LYH-94/BalanceCar/README.md

# 平衡車 ( BalanceCar )

無回授步進馬達版本：[BalanceCar_StepMotor](https://github.com/LYH-94/BalanceCar/tree/main/BalanceCar_StepMotor)
