LYH-94/BalanceCar/BalanceCar_StepMotor/Core/Src/main.c

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
/* Includes ------------------------------------------------------------------*/
#include "main.h"

/* USER CODE BEGIN Includes */
#include <stdlib.h>
#include "mpu6050.h"
#include "A4988_Driver.h"

/* USER CODE END Includes */

/* USER CODE BEGIN PD */
#ifdef __GNUC__
  #define PUTCHAR_PROTOTYPE int __io_putchar(int ch)
#else#define PUTCHAR_PROTOTYPE int fputc(int ch, FILE *f)
#endif /* __GNUC__ */
/* USER CODE END PD */

I2C_HandleTypeDef hi2c1;

TIM_HandleTypeDef htim2;
TIM_HandleTypeDef htim3;

UART_HandleTypeDef huart2;

/* USER CODE BEGIN PV */
MPU6050_HandleTypeDef MPU6050;
uint8_t count1 = 0, count2 = 0;

double balance_point = 6.0;
double reference_input_angle = 0.0;
double reference_input_speed = 0.0;

double error_angle = 0.0;
double error_speed = 0.0;
double error_speed_LFP = 0.0, alpha = 0.2;  // LPF means low pass filter.
double control_law_angle = 0.0;
double control_law_speed = 0.0;
double control_law_speed_LFP = 0.0, beta = 0.5;

double PID_speed_time = 0.0;
double PID_speed_delta_time = 0.0;
double PID_speed_integral = 0.0;
double PID_speed_error_pre = 0.0;

double PID_angle_time = 0.0;
double PID_angle_delta_time = 0.0;
double PID_angle_integral = 0.0;

/* USER CODE END PV */

void SystemClock_Config(void);
static void MX_GPIO_Init(void);
static void MX_USART2_UART_Init(void);
static void MX_I2C1_Init(void);
static void MX_TIM2_Init(void);
static void MX_TIM3_Init(void);
/* USER CODE BEGIN PFP */
double PID_angle_controller(double error);
double PID_speed_controller(double error);

/* USER CODE END PFP */

/**
  * @brief  The application entry point.
  * @retval int
  */
int main(void)
{
  /* MCU Configuration--------------------------------------------------------*/

  /* Reset of all peripherals, Initializes the Flash interface and the Systick. */
  HAL_Init();

  /* Configure the system clock */
  SystemClock_Config();

  /* USER CODE BEGIN SysInit */
  SysTick_Config(SystemCoreClock / 1000);

  /* USER CODE END SysInit */

  /* Initialize all configured peripherals */
  MX_GPIO_Init();
  MX_USART2_UART_Init();
  MX_I2C1_Init();
  MX_TIM2_Init();
  MX_TIM3_Init();
  /* USER CODE BEGIN 2 */
  StepMotorDriver_Iint(&htim2);
  StepMotorDriver_Iint(&htim3);

  if (mpu6050_Init_Correction(&hi2c1, &MPU6050) == 1)
  {
    Error_Handler();
  }

  /* USER CODE END 2 */

  /* Infinite loop */
  /* USER CODE BEGIN WHILE */
  while (1)
  {
    /* USER CODE END WHILE */

    /* USER CODE BEGIN 3 */
	while(count1 == 1)
	{
		KalmanFilter_getAngle(&hi2c1, &MPU6050);

		error_speed = reference_input_speed + control_law_speed_LFP;
		error_speed_LFP = alpha * error_speed + (1-alpha) * error_speed_LFP;  // Low pass filter
		control_law_angle = PID_speed_controller(error_speed_LFP);

		error_angle = reference_input_angle - MPU6050.KalmanFilter_AngleX + balance_point;
		control_law_speed = PID_angle_controller(error_angle) + control_law_angle;

		control_law_speed_LFP = beta * control_law_speed + (1-beta) * control_law_speed_LFP;  // Low pass filter

		if(control_law_speed_LFP > 1081.73) control_law_speed_LFP = 1081.73;  // Maximum limit
		if(control_law_speed_LFP < -1081.73) control_law_speed_LFP = -1081.73;

		printf("KF_AngleX = %f \t, error_angle = %f \t, control_law_speed_LFP = %f\n" \
				, MPU6050.KalmanFilter_AngleX, error_angle, control_law_speed_LFP);

		if(abs((int)error_angle) > 45)
		{
			StepMotor_Stop(&htim2);
			StepMotor_Stop(&htim3);
		}
		else if(abs((int)control_law_speed_LFP) < 1.502)
		{
			StepMotor_Stop(&htim2);
			StepMotor_Stop(&htim3);
		}
		else
		{
			// control_law_speed_LFP (unit:deg/sec)(>0 = forward; <0 = back), (1=left motor; 0=right motor)
			StepMotor_Control(&htim2, control_law_speed_LFP, 1);
			StepMotor_Control(&htim3, control_law_speed_LFP, 0);
		}

		while(count1 == 1 && count2 > 2)
		{
			StepMotor_Stop(&htim2);
			StepMotor_Stop(&htim3);
		}
	}
  }
  /* USER CODE END 3 */
}

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
/* USER CODE BEGIN 4 */
double PID_angle_controller(double error)
{
	uint8_t index = 0;
	double P = 0.0, I = 0.0, D = 0.0;
	double Kp = 15.0, Ki = 5.0, Kd = 1.5;
	double u = 0.0;

	PID_angle_delta_time = (double)(HAL_GetTick() - PID_angle_time) / 1000;
	PID_angle_time = HAL_GetTick();

	P = Kp * error;

	if(abs((int)error) > 45)  // Integral separation method
	{
		index = 0;
	}
	else
	{
		index = 1;
		PID_angle_integral += error * PID_angle_delta_time/1000.0;
	}
	I = Ki * PID_angle_integral;
	if(I > 1000) I = 1000;  // Maximum limit I
	if(I < -1000) I = -1000;

	D = Kd * MPU6050.Gyro_Y_AngVel;

	u = P + index * I + D;

	return u;
}

double PID_speed_controller(double error)
{
	double P = 0.0, I = 0.0, D = 0.0;
	double Kp = 1.03, Ki = Kp/200.0, Kd = 0.0;
	double u = 0.0;

	PID_speed_delta_time = (double)(HAL_GetTick() - PID_speed_time) / 1000;
	PID_speed_time = HAL_GetTick();

	P = Kp * error;

	PID_speed_integral += error * PID_speed_delta_time/1000.0;
	I = Ki * PID_speed_integral;
	if(I > 1000) I = 1000;  // Maximum limit I
	if(I < -1000) I = -1000;

	D = Kd * (error - PID_speed_error_pre)/(PID_speed_delta_time/1000.0);
	PID_speed_error_pre = error;

	u = P + I + D;

	return u;
}

void HAL_GPIO_EXTI_Callback(uint16_t GPIO_Pin)
{
  /* Prevent unused argument(s) compilation warning */
  UNUSED(GPIO_Pin);
  /* NOTE: This function Should not be modified, when the callback is needed,
           the HAL_GPIO_EXTI_Callback could be implemented in the user file
   */

  if(GPIO_Pin == B1_Pin){
        count1 = 1;
	count2 += 1;
  }
}

PUTCHAR_PROTOTYPE
{
HAL_UART_Transmit(&huart2, (uint8_t *)&ch, 1, 0xFFFF);
return ch;
}

/* USER CODE END 4 */
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
