LYH-94/BalanceCar/BalanceCar_StepMotor/Core/Inc/main.h

#define B1_Pin GPIO_PIN_13
#define B1_GPIO_Port GPIOC
#define B1_EXTI_IRQn EXTI15_10_IRQn
#define USART_TX_Pin GPIO_PIN_2
#define USART_TX_GPIO_Port GPIOA
#define USART_RX_Pin GPIO_PIN_3
#define USART_RX_GPIO_Port GPIOA
#define LD2_Pin GPIO_PIN_5
#define LD2_GPIO_Port GPIOA
#define PB12_ENA_Pin GPIO_PIN_12
#define PB12_ENA_GPIO_Port GPIOB
#define PB13_MS1_Pin GPIO_PIN_13
#define PB13_MS1_GPIO_Port GPIOB
#define PB14_MS2_Pin GPIO_PIN_14
#define PB14_MS2_GPIO_Port GPIOB
#define PB15_MS3_Pin GPIO_PIN_15
#define PB15_MS3_GPIO_Port GPIOB
#define PA8_DIR_L_Pin GPIO_PIN_8
#define PA8_DIR_L_GPIO_Port GPIOA
#define PA9_DIR_R_Pin GPIO_PIN_9
#define PA9_DIR_R_GPIO_Port GPIOA
#define TMS_Pin GPIO_PIN_13
#define TMS_GPIO_Port GPIOA
#define TCK_Pin GPIO_PIN_14
#define TCK_GPIO_Port GPIOA
#define SWO_Pin GPIO_PIN_3
#define SWO_GPIO_Port GPIOB
